cctvfm/sigil/README.md

# sigil
An ultra-compact contact mic with integrated phantom-powered JFET pre-amp

https://www.cctv.fm/product-page/sigil-transducer-diy-contact-mic-kit
cctv.fm/sigil
