cctvfm/sigil/Sigil List of Materials-01.jpg

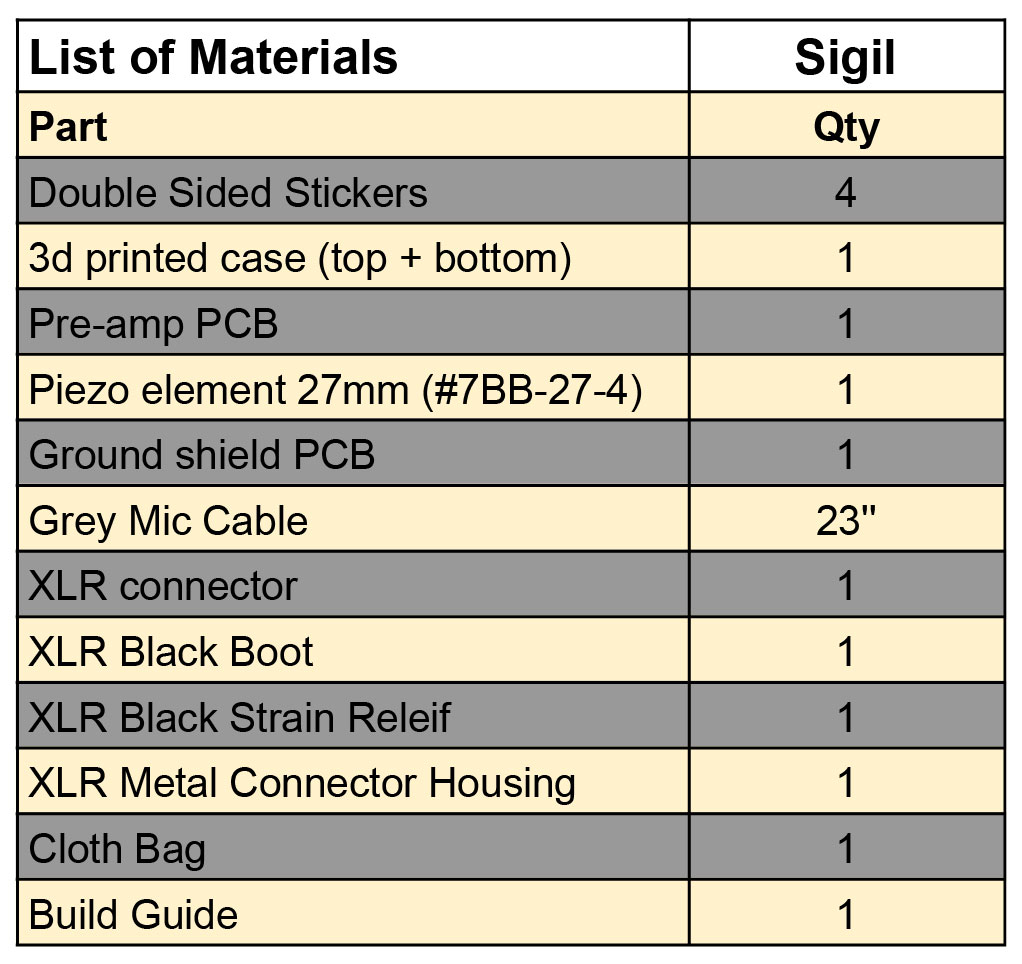
Sigil List of Materials-01.jpg
