cctvfm/sigil/Piezo-schematic.pdf

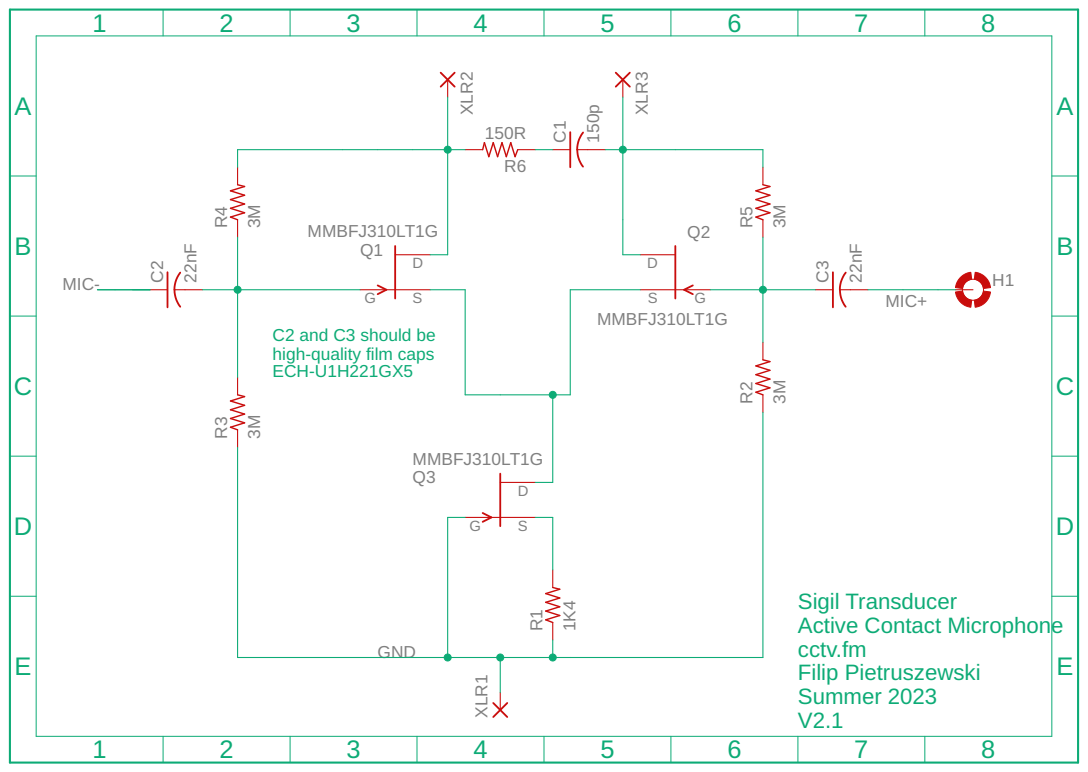
[picture p2: page 1]

C2 and C3 should be
high-quality film caps
ECH-U1H221GX5
