cctvfm/sigil/Piezo-pcb.pdf

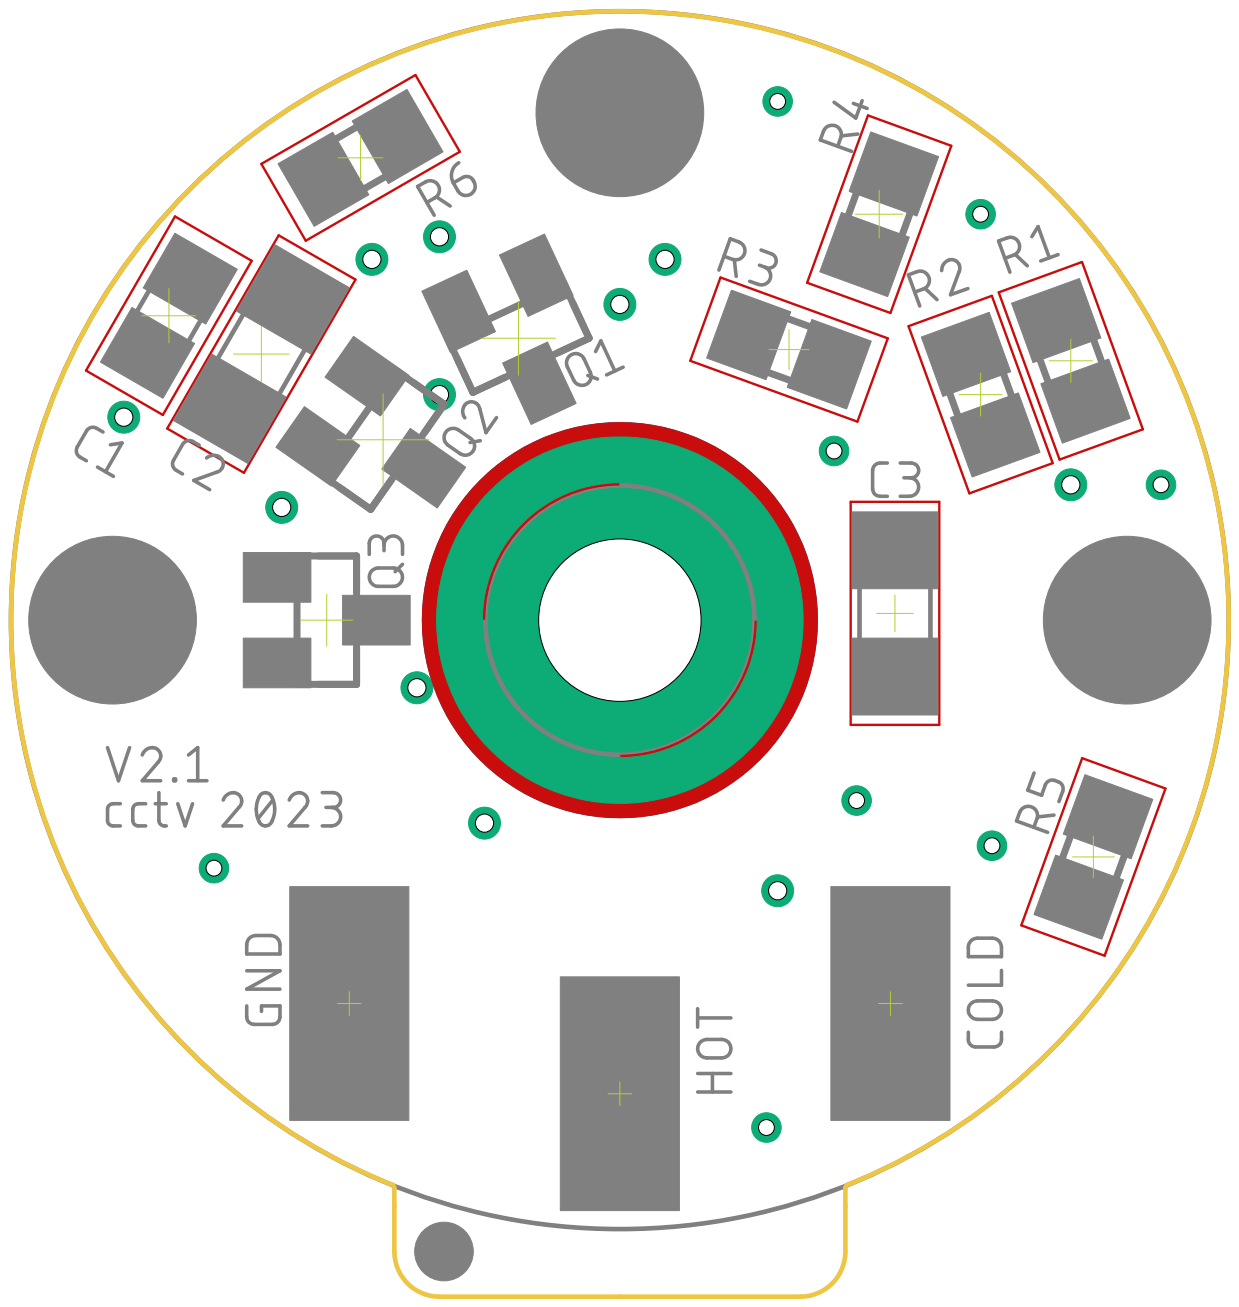
[picture p3: page 1]
