cctvfm/sigil/Piezo.brd

## EAGLE design Piezo.brd (2023-08-03)

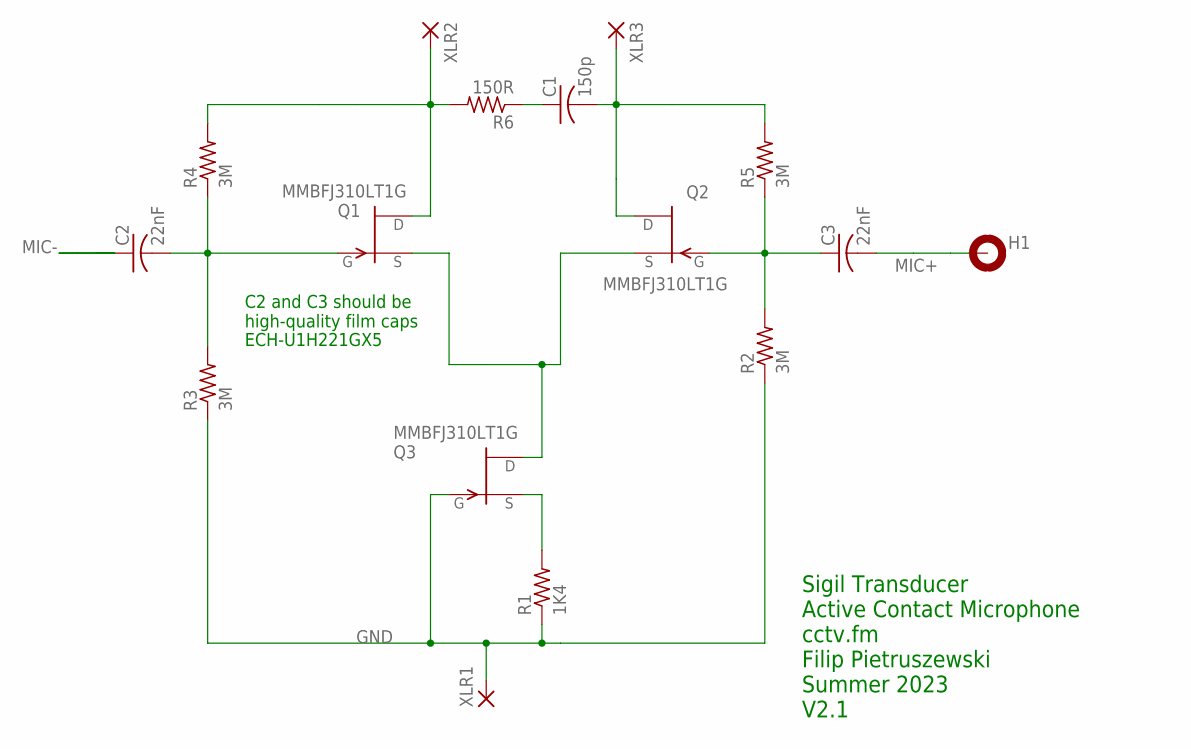
[picture p4: schematic Piezo.sch]

Parts:
C1: 150p; C0805
C2, C3: 22nF; C1206
H1: MOUNT-PAD-ROUND3.6; 3,6-PAD
Q1, Q2, Q3: MMBFJ310LT1G; SOT23
R1: 1K4; R0805
R2, R3, R4, R5: 3M; R0805
R6: 150R; R0805
XLR1, XLR2, XLR3: DNP; SMD2,54-5,08

Connections:
GND: Q3.3 (G), R1.1, R2.1, R3.1, XLR1.1
MIC+: C3.2, H1.B3,6
MIC-: C2.1
unnamed: Q1.2 (S), Q2.2 (S), Q3.1 (D)
unnamed: C2.2, Q1.3 (G), R3.2, R4.1
unnamed: C3.1, Q2.3 (G), R2.2, R5.1
unnamed: Q1.1 (D), R4.2, R6.2, XLR2.1
unnamed: Q3.2 (S), R1.2
unnamed: C1.1, R6.1
unnamed: C1.2, Q2.1 (D), R5.2, XLR3.1

Notes on the sheet:
ECH-U1H221GX5
C2 and C3 should be high-quality film caps
Sigil Transducer Active Contact Microphone cctv.fm Filip Pietruszewski Summer 2023 V2.1

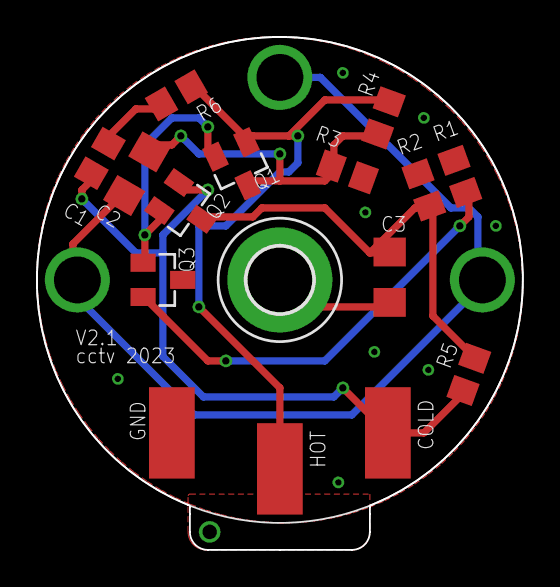
[picture p5: board Piezo.brd from above]

Board: 2 copper layers, 27.0 x 28.5 mm, 16 parts (0 on the bottom side), 9 nets.
