cctvfm/sigil/Sigil Transducer Contact Mic Build Guide.pdf

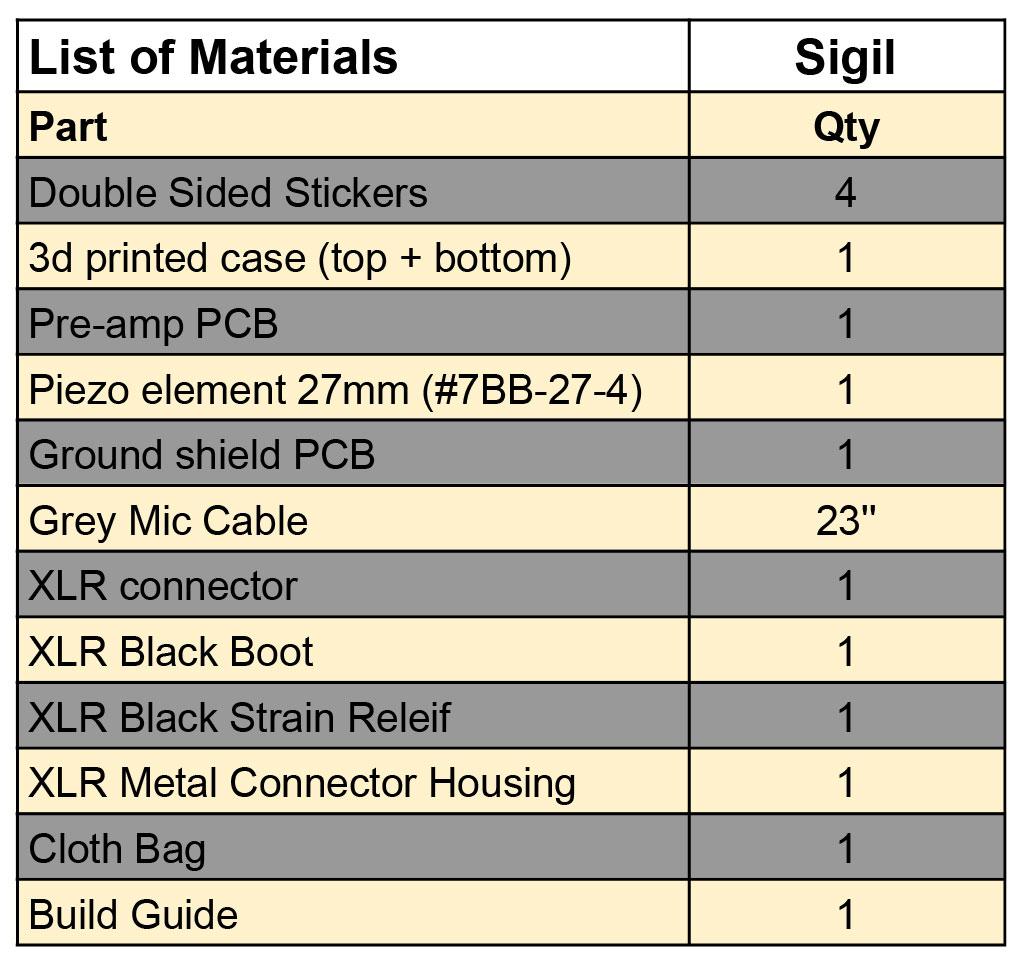
[picture p19: figure]
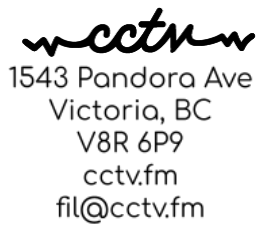
[picture p20: figure]
